quarterturn/organ-midi-project/README

This is the project repository for the 2012 Maker Faire project MIDIfying Old Organs
