quarterturn/organ-midi-project/shift-in-midi/shift-in-midi.png

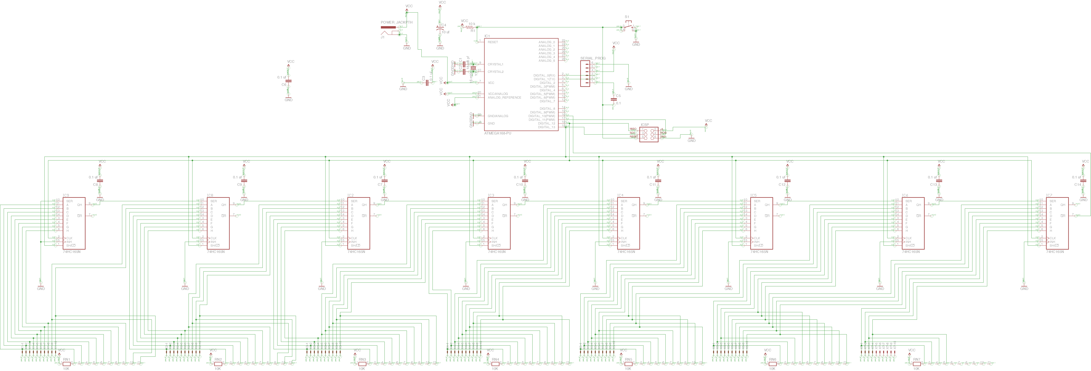
shift-in-midi/shift-in-midi.png
