quarterturn/organ-midi-project/shift-in-midi/shift-in-midi.brd

## EAGLE design shift-in-midi/shift-in-midi.brd (2012-06-07)

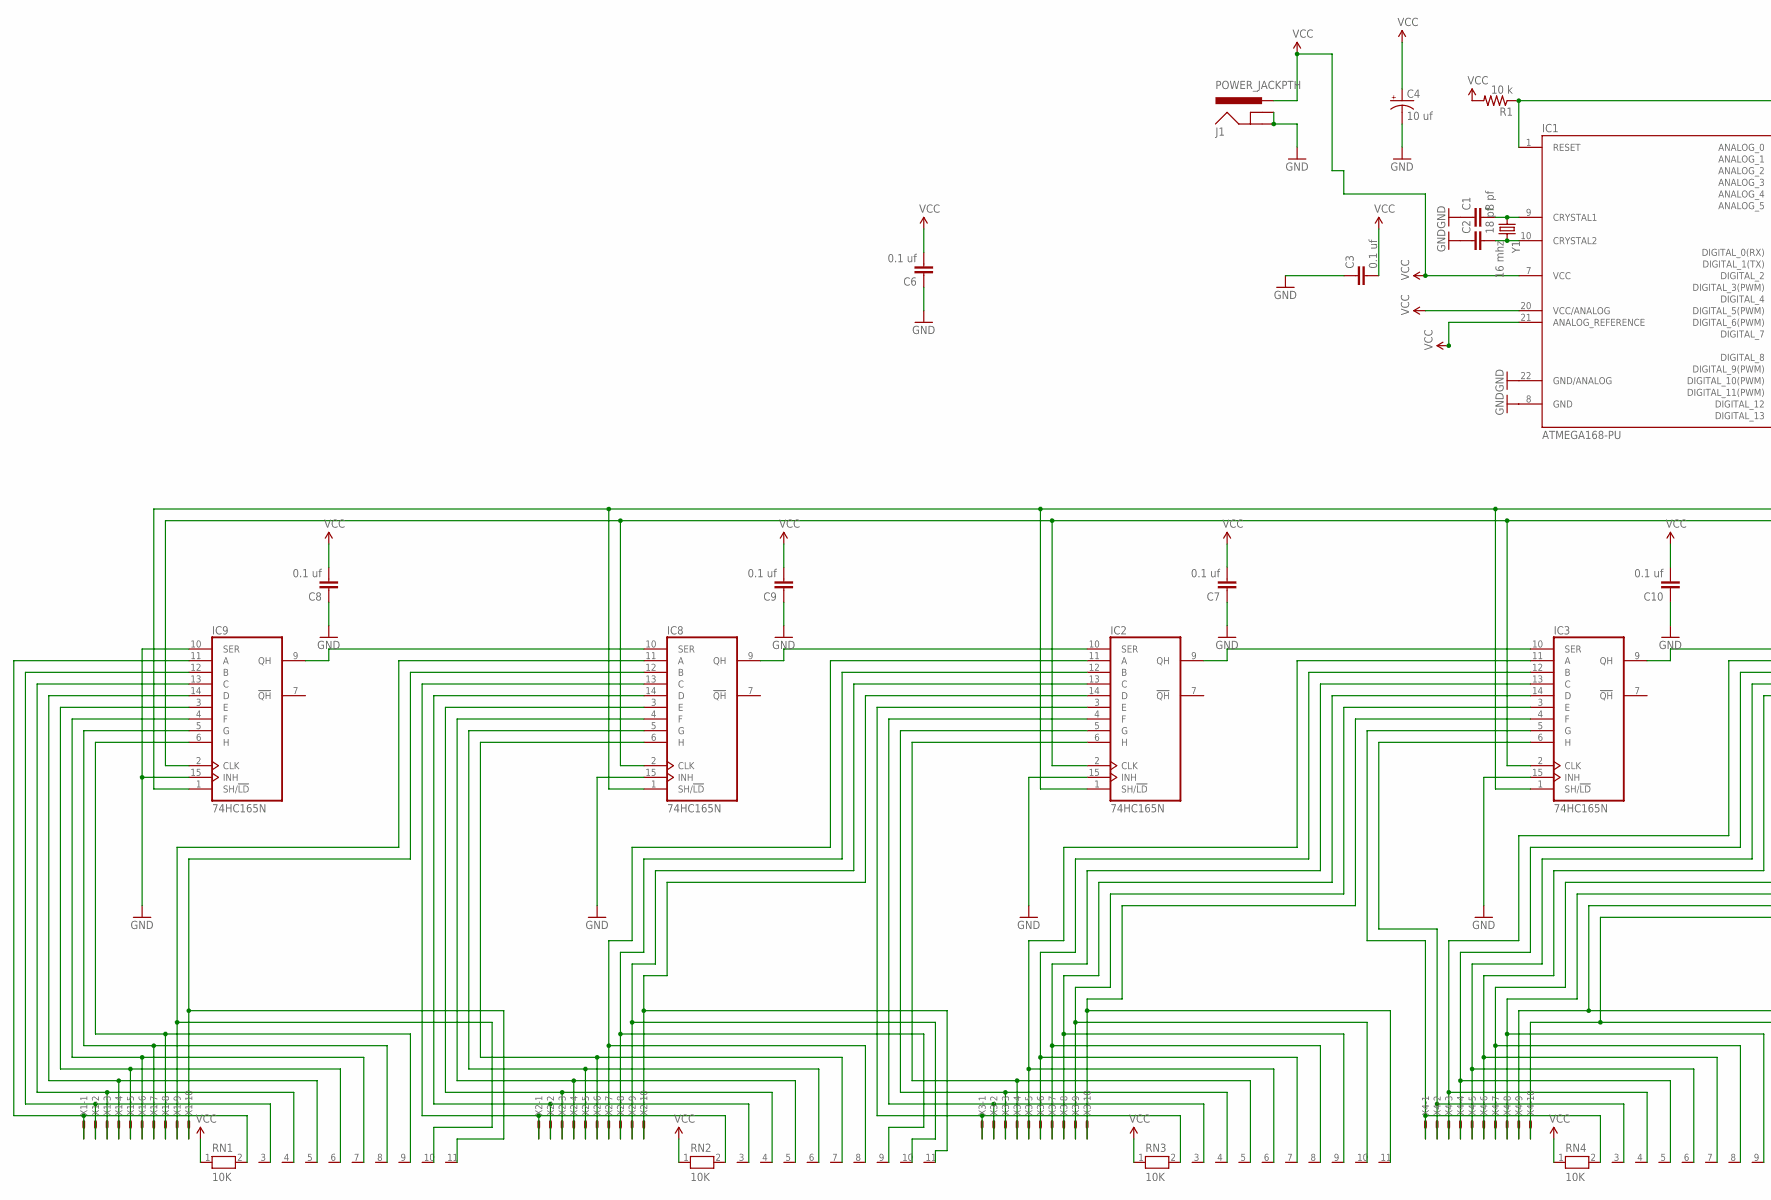
[picture p2: schematic shift-in-midi.sch, part in row 1, column 1]

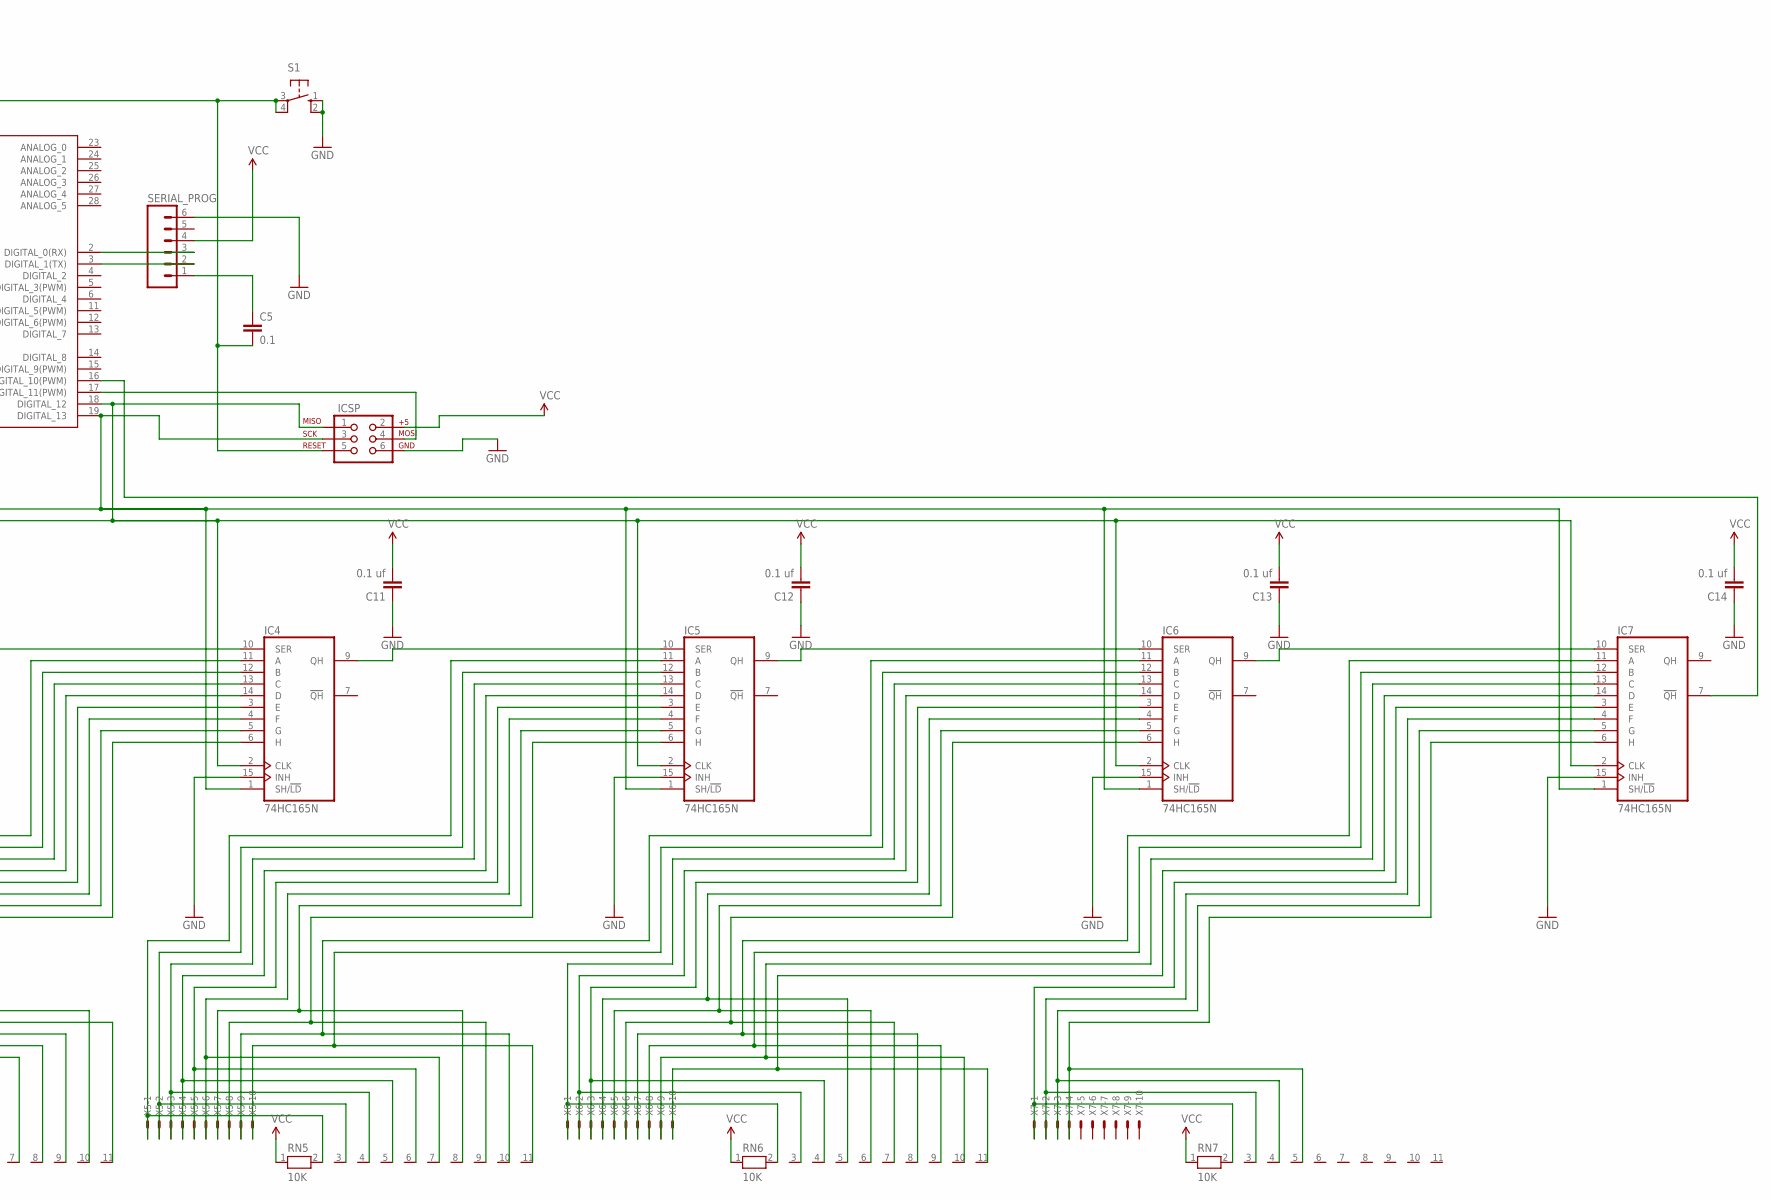
[picture p3: schematic shift-in-midi.sch, part in row 1, column 2]

Parts:
C1: 8 pf; CAP-PTH-SMALL2
C2: 18 pf; CAP-PTH-SMALL2
C3, C6, C7, C8, C9, C10, C11, C12, C13, C14: 0.1 uf; CAP-PTH-SMALL2
C4: 10 uf; CPOL-RADIAL-10UF-25V
C5: 0.1; CAP-PTH-SMALL
IC1: ATMEGA168-PU; DIL28-3
IC2, IC3, IC4, IC5, IC6, IC7, IC8, IC9: 74HC165N; DIL16
ICSP: AVR_SPI_PRG_62X3_LOCK; 2X3_LOCK
J1: POWER_JACKPTH; POWER_JACK_PTH
R1: 10 k; AXIAL-0.4
RN1, RN2, RN3, RN4, RN5, RN6, RN7: 10K; RN-11
S1: 10-XX; B3F-10XX
SERIAL_PROG: M06LONGPADS; 1X06_LONGPADS
X1, X2, X3, X4, X5, X6, X7: KK-156-10
Y1: 16 mhz; HC49US

Connections:
GND: C1.1, C2.1, C3.1, C4.2 (-), C6.1, C7.1, C8.1, C9.1, C10.1, C11.1, C12.1, C13.1, C14.1, IC1.8 (GND), IC1.22 (GND/ANALOG), IC2.8 (GND), IC2.15 (INH), IC3.8 (GND), IC3.15 (INH), IC4.8 (GND), IC4.15 (INH), IC5.8 (GND), IC5.15 (INH), IC6.8 (GND), IC6.15 (INH), IC7.8 (GND), IC7.15 (INH), IC8.8 (GND), IC8.15 (INH), IC9.8 (GND), IC9.10 (SER), IC9.15 (INH), ICSP.6, J1.GND, J1.GNDBREAK, S1.1 (S), S1.2 (S1), SERIAL_PROG.6
unnamed: C5.2, IC1.1 (RESET), ICSP.5, R1.P$1 (1), S1.3, S1.4 (P1)
unnamed: IC1.19 (DIGITAL_13), IC2.1 (SH/!LD), IC3.1 (SH/!LD), IC4.1 (SH/!LD), IC5.1 (SH/!LD), IC6.1 (SH/!LD), IC7.1 (SH/!LD), IC8.1 (SH/!LD), IC9.1 (SH/!LD), ICSP.3
unnamed: C1.2, IC1.9 (CRYSTAL1), Y1.1
unnamed: C2.2, IC1.10 (CRYSTAL2), Y1.2
unnamed: IC8.10 (SER), IC9.9 (QH)
unnamed: IC2.10 (SER), IC8.9 (QH)
unnamed: C5.1, SERIAL_PROG.1
unnamed: IC1.18 (DIGITAL_12), IC2.2 (CLK), IC3.2 (CLK), IC4.2 (CLK), IC5.2 (CLK), IC6.2 (CLK), IC7.2 (CLK), IC8.2 (CLK), IC9.2 (CLK), ICSP.1
unnamed: IC1.2 (DIGITAL_0(RX)), SERIAL_PROG.3
unnamed: IC1.3 (DIGITAL_1(TX)), SERIAL_PROG.2
unnamed: IC2.9 (QH), IC3.10 (SER)
unnamed: IC3.9 (QH), IC4.10 (SER)
unnamed: IC4.9 (QH), IC5.10 (SER)
unnamed: IC5.9 (QH), IC6.10 (SER)
unnamed: IC6.9 (QH), IC7.10 (SER)
unnamed: IC1.17 (DIGITAL_11(PWM)), ICSP.4
unnamed: IC1.16 (DIGITAL_10(PWM)), IC7.7 (!QH)
unnamed: IC9.11 (A), RN1.2, X1.1
unnamed: IC9.12 (B), RN1.3, X1.2
unnamed: IC9.13 (C), RN1.4, X1.3
unnamed: IC8.12 (B), RN1.11, X1.10
unnamed: IC9.3 (E), RN1.6, X1.5
unnamed: IC9.4 (F), RN1.7, X1.6
unnamed: IC9.5 (G), RN1.8, X1.7
unnamed: IC9.6 (H), RN1.9, X1.8
unnamed: IC8.11 (A), RN1.10, X1.9
unnamed: IC8.13 (C), RN2.2, X2.1
unnamed: IC8.14 (D), RN2.3, X2.2
unnamed: IC8.3 (E), RN2.4, X2.3
unnamed: IC8.4 (F), RN2.5, X2.4
unnamed: IC8.5 (G), RN2.6, X2.5
unnamed: IC4.6 (H), RN4.11, X4.10
unnamed: IC2.11 (A), RN2.8, X2.7
unnamed: IC2.12 (B), RN2.9, X2.8
unnamed: IC2.13 (C), RN2.10, X2.9
unnamed: IC2.14 (D), RN2.11, X2.10
unnamed: IC2.3 (E), RN3.2, X3.1
unnamed: IC2.4 (F), RN3.3, X3.2
unnamed: IC2.5 (G), RN3.4, X3.3
unnamed: IC2.6 (H), RN3.5, X3.4
unnamed: IC3.11 (A), RN3.6, X3.5
unnamed: IC3.12 (B), RN3.7, X3.6
unnamed: IC3.13 (C), RN3.8, X3.7
unnamed: IC3.14 (D), RN3.9, X3.8
unnamed: IC3.3 (E), RN3.10, X3.9
unnamed: IC3.4 (F), RN3.11, X3.10
unnamed: IC3.5 (G), RN4.2, X4.1
unnamed: IC3.6 (H), RN4.3, X4.2
unnamed: IC4.11 (A), RN4.4, X4.3
unnamed: IC4.12 (B), RN4.5, X4.4
unnamed: IC4.13 (C), RN4.6, X4.5
unnamed: IC4.14 (D), RN4.7, X4.6
unnamed: IC4.3 (E), RN4.8, X4.7
unnamed: IC4.4 (F), RN4.9, X4.8
unnamed: IC4.5 (G), RN4.10, X4.9
unnamed: IC5.11 (A), RN5.2, X5.1
unnamed: IC5.12 (B), RN5.3, X5.2
unnamed: IC5.13 (C), RN5.4, X5.3
unnamed: IC5.14 (D), RN5.5, X5.4
unnamed: IC5.3 (E), RN5.6, X5.5
unnamed: IC5.4 (F), RN5.7, X5.6
unnamed: IC5.5 (G), RN5.8, X5.7
unnamed: IC5.6 (H), RN5.9, X5.8
unnamed: IC6.11 (A), RN5.10, X5.9
unnamed: IC6.12 (B), RN5.11, X5.10
unnamed: IC6.13 (C), RN6.2, X6.1
unnamed: IC6.14 (D), RN6.3, X6.2
unnamed: IC6.3 (E), RN6.4, X6.3
unnamed: IC6.4 (F), RN6.5, X6.4
unnamed: IC6.5 (G), RN6.6, X6.5
unnamed: IC6.6 (H), RN6.7, X6.6
unnamed: IC7.11 (A), RN6.8, X6.7
unnamed: IC7.12 (B), RN6.9, X6.8
unnamed: IC7.13 (C), RN6.10, X6.9
unnamed: IC7.14 (D), RN6.11, X6.10
unnamed: IC7.3 (E), RN7.2, X7.1
unnamed: IC7.4 (F), RN7.3, X7.2
unnamed: IC7.5 (G), RN7.4, X7.3
unnamed: IC7.6 (H), RN7.5, X7.4
unnamed: IC9.14 (D), RN1.5, X1.4
unnamed: IC8.6 (H), RN2.7, X2.6
VCC: C3.2, C4.1 (+), C6.2, C7.2, C8.2, C9.2, C10.2, C11.2, C12.2, C13.2, C14.2, IC1.7 (VCC), IC1.20 (VCC/ANALOG), IC1.21 (ANALOG_REFERENCE), IC2.16 (VCC), IC3.16 (VCC), IC4.16 (VCC), IC5.16 (VCC), IC6.16 (VCC), IC7.16 (VCC), IC8.16 (VCC), IC9.16 (VCC), ICSP.2, J1.PWR, R1.P$2 (2), RN1.1, RN2.1, RN3.1, RN4.1, RN5.1, RN6.1, RN7.1, SERIAL_PROG.4

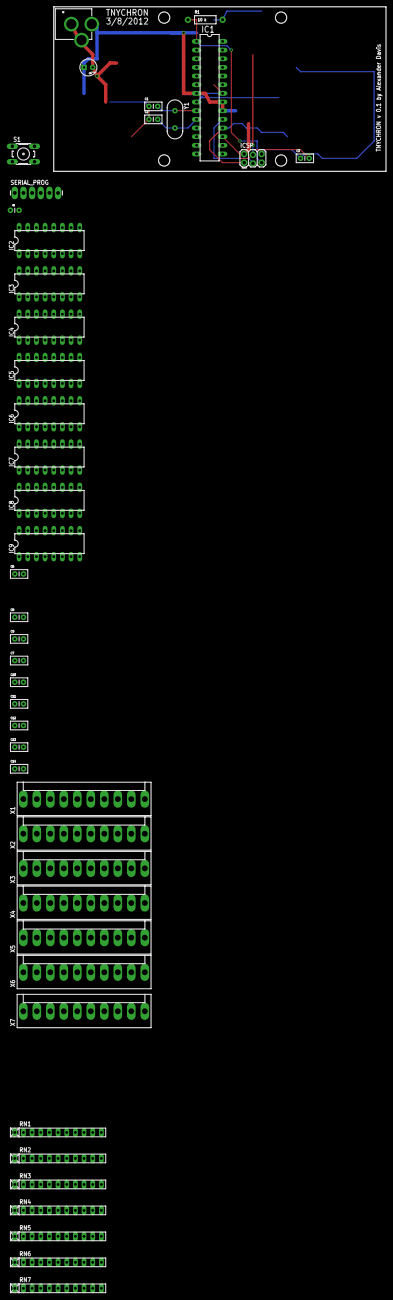
[picture p4: board shift-in-midi.brd from above]

Board: 2 copper layers, 97.5 x 48.2 mm, 47 parts (0 on the bottom side), 83 nets.

Other parts of the board:
U$4, U$5, U$6, U$7: STAND-OFF
