quarterturn/organ-midi-project/(commit log)

2012-05-10 Fixed libraries "Fluxamasynth" and "HpDecVfd" to work with Arduino 1.0
    [Brightness.pde, FluxamasnthBendingNotes.pde, Fluxamasynth.cpp, Fluxamasynth.h, FluxamasynthCrossFading.ino, FluxamasynthDrumPatternPlayer.ino, FluxamasynthPlayAllVoices.ino, HelloWorld.pde]
2012-05-28 arduino code version 0.0.3
    This version is tested and working.
2012-06-07 added Eagle schematic
    [shift-in-midi.brd, shift-in-midi.sch]
2012-06-14 v 0.0.4 with vfd and pot/button control panel
2012-06-14 update to section on velocity sensing and RAM
